Diarmuid1812/SensorNetworkDB/Arduino/KiCad_PCB_Humidity_Sensor_v5/Humidity_Sensor-Schematic.pdf

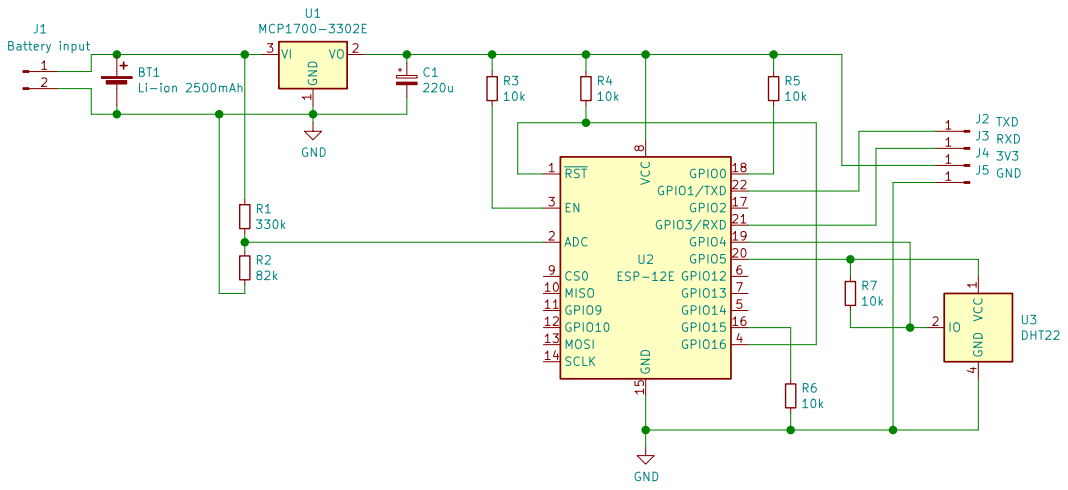
[picture p1: page 1]
