Diarmuid1812/SensorNetworkDB/Arduino/KiCad_PCB_Humidity_Sensor_v5/Humidity_Sensor-F-PCB.pdf

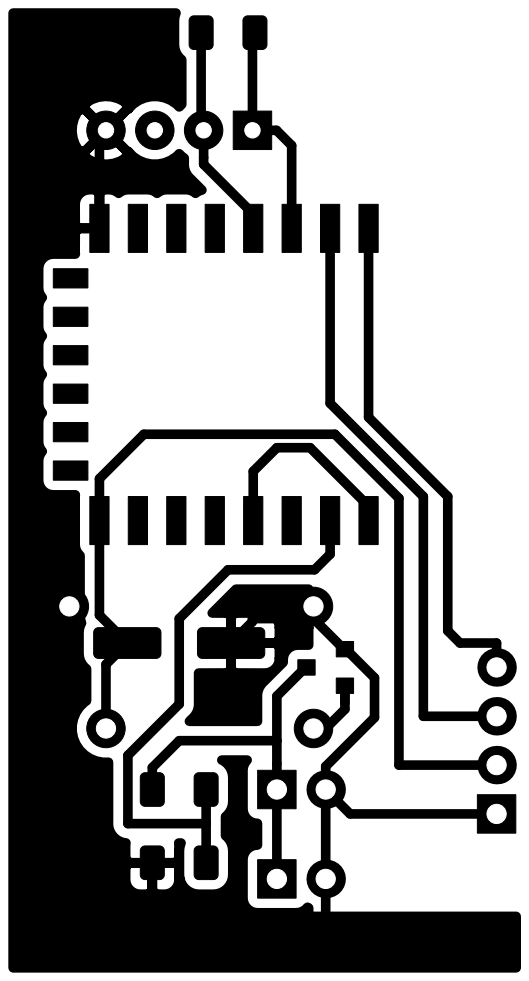
[picture p2: page 1]
