Diarmuid1812/SensorNetworkDB/Arduino/KiCad_PCB_Humidity_Sensor_v5/Humidity_Sensor.kicad_pcb

## KiCad design Arduino/KiCad_PCB_Humidity_Sensor_v5/Humidity_Sensor.kicad_pcb (2020-07-20)

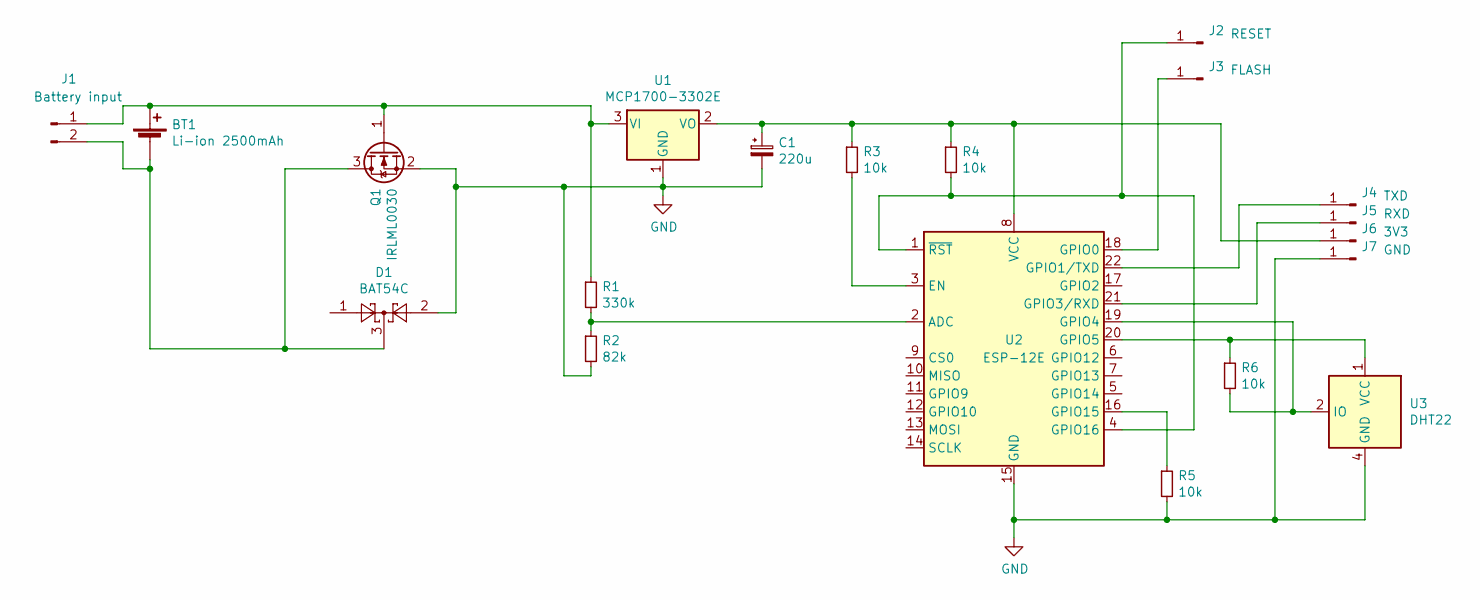
[picture p3: schematic Humidity_Sensor.sch]

Parts:
BT1: Li-ion 2500mAh; PinHeader_1x02_P2.54mm_Vertical
C1: 220u; CP_Elec_6.3x7.7
D1: BAT54C; SOT-23
J1: Battery input; PinHeader_1x02_P2.54mm_Vertical
J2: RESET; PinHeader_1x01_P2.54mm_Vertical
J3: FLASH; PinHeader_1x01_P2.54mm_Vertical
J4: TXD; PinHeader_1x01_P2.54mm_Vertical
J5: RXD; PinHeader_1x01_P2.54mm_Vertical
J6: 3V3; PinHeader_1x01_P2.54mm_Vertical
J7: GND; PinHeader_1x01_P2.54mm_Vertical
Q1: IRLML0030; SOT-23
R1: 330k; R_1206_3216Metric
R2: 82k; R_1206_3216Metric
R3, R4, R5, R6: 10k; R_1206_3216Metric
U1: MCP1700-3302E; SOT-23
U2: ESP-12E
U3: DHT22; Aosong_DHT11_5.5x12.0_P2.54mm

Connections:
GND: C1.2, D1.2, J7.1, Q1.2 (S), R2.2, R5.2, U1.1 (GND), U2.15 (GND), U3.4 (GND)
unnamed: BT1.1 (+), J1.1, Q1.1 (G), R1.1, U1.3 (VI)
unnamed: BT1.2 (-), D1.3, J1.2, Q1.3 (D)
unnamed: C1.1, J6.1, R3.1, R4.1, U1.2 (VO), U2.8 (VCC)
unnamed: J2.1, R4.2, U2.1 (~RST), U2.4 (GPIO16)
unnamed: J3.1, U2.18 (GPIO0)
unnamed: J4.1, U2.22 (GPIO1/TXD)
unnamed: J5.1, U2.21 (GPIO3/RXD)
unnamed: R1.2, R2.1, U2.2 (ADC)
unnamed: R3.2, U2.3 (EN)
unnamed: R5.1, U2.16 (GPIO15)
unnamed: R6.1, U2.20 (GPIO5), U3.1 (VCC)
unnamed: R6.2, U2.19 (GPIO4), U3.2 (IO)

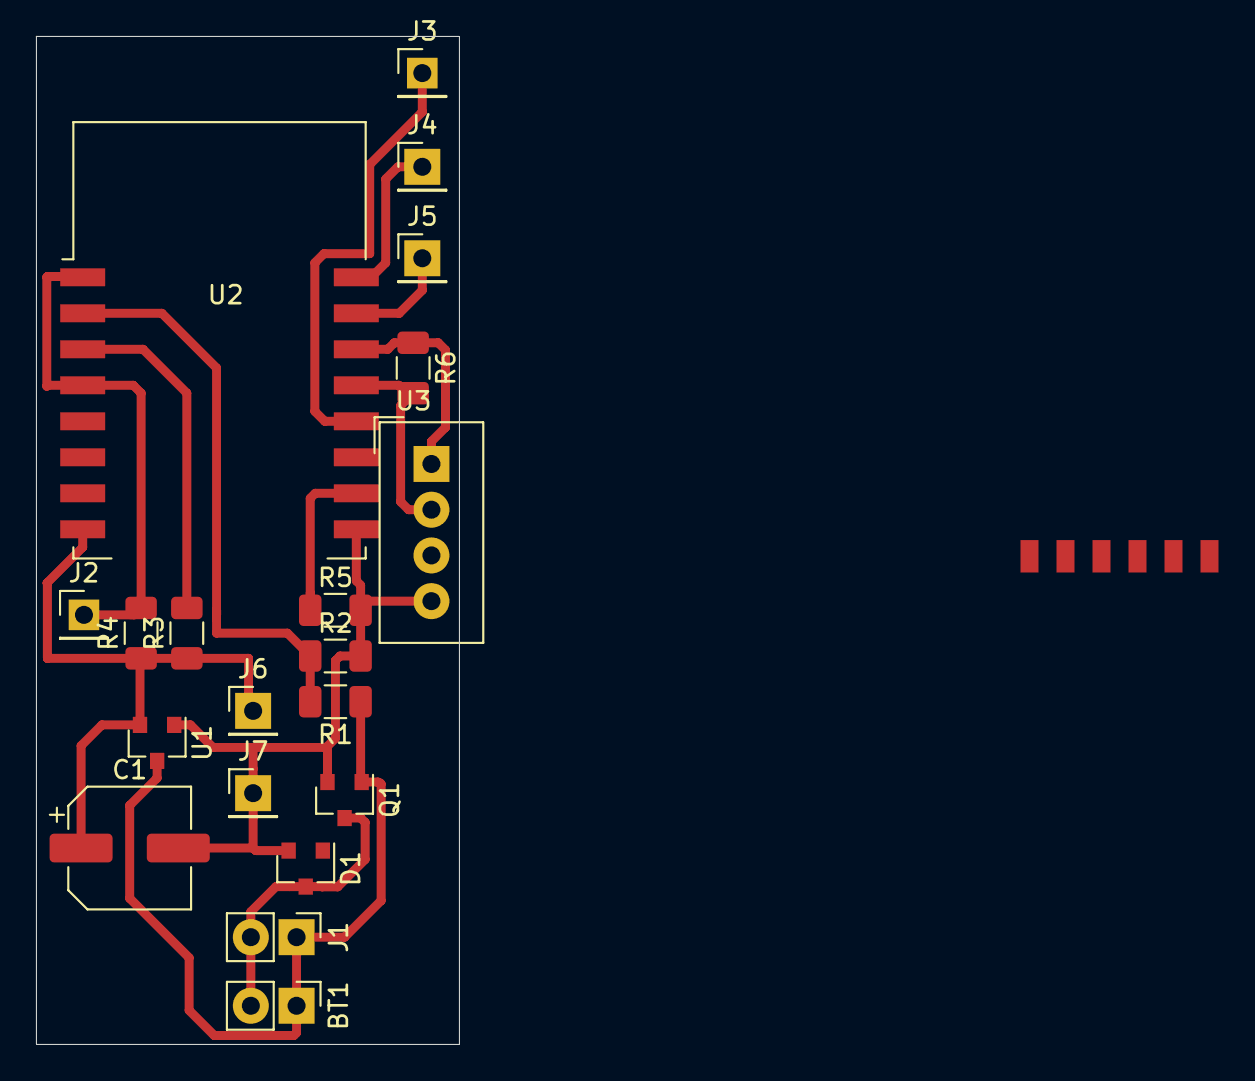
[picture p4: board Humidity_Sensor.kicad_pcb from above]

Board: 2 copper layers, 23.5 x 56.0 mm, 20 parts (0 on the bottom side), 13 nets.
