Diarmuid1812/SensorNetworkDB/Arduino/SensorNetwork/SensorNetwork.ino

#include "src/DHT_sensor_library/DHT.h"
#include <ESP8266WiFi.h>
#include <ESP8266HTTPClient.h>
#include <WiFiClient.h>
#include <EEPROM.h>

#include "user_interface.h"

#define DHTTYPE DHT22
#define DHT_VCC D1
#define DHT_PIN D2

#define SSID_EEPROM_ADDR 10
#define PASSWD_EEPROM_ADDR 50
#define IP_EEPROM_ADDR 90
#define RTCMEMORYSTART 65

#define SLEEP_TIME 3600                              //SLEEP_TIME to czas sekund jednego cyklu spania - docelowo godzina 60*60 = 3600 sekund

#define SENSOR_ID 1                               // <-- tutaj zmienić ID czujnika

typedef struct {
  int count;
} rtcStore;

DHT dht(DHT_PIN, DHTTYPE);

rtcStore rtcMem;

void setup()
{
  //uruchomienie portu szeregowego
  Serial.begin(74880);
  readFromRTCMemory();

  //czujnik ma się uruchamiać co 6 godzin
  if ((rtcMem.count <= 5) && (rtcMem.count >= 0))
  {
    Serial.print("Sleep number:");
    Serial.println(rtcMem.count);
    Serial.println("##########################################");
    rtcMem.count++;
    writeToRTCMemory();
    ESP.deepSleep(SLEEP_TIME * 1e6);
  }
  Serial.print("Sleep number:");
  Serial.println(rtcMem.count);
  rtcMem.count = 0;
  writeToRTCMemory();



  //ustawienie GPIO jako output
  pinMode(DHT_VCC, OUTPUT);
  //zasilenie czujnika DHT z GPIO
  digitalWrite(DHT_VCC, HIGH);
  //inicjalizacja czujnika wilgotności
  dht.begin();
  //uruchomienie EEPROM
  EEPROM.begin(512);

  String ssid = "ssid";
  String password = "password";
  String server_ip = "255.255.255.255";

  Serial.println("Waiting for wifi config");
  delay(3000);

  if (Serial.available() > 0)
  {
    String configMsg;
    configMsg = Serial.readString();

    //identyfikacja komendy nazwy sieci
    if (configMsg.substring(0, 5) == "ssid=")
    {
      ssid = configMsg.substring(5, configMsg.length() - 1);
      Serial.println("New ssid reeived");
      //Serial.println(ssid);

      //zapis ssid do EEPROM
      for (int i = 0; i < ssid.length(); i++)
      {
        char c = ssid[i];
        EEPROM.write(SSID_EEPROM_ADDR + i, c);
      }
      EEPROM.write(SSID_EEPROM_ADDR - 1, ssid.length());
      EEPROM.commit();
    }

    //identyfikacja komendy hasła
    if (configMsg.substring(0, 7) == "passwd=")
    {
      password = configMsg.substring(7, configMsg.length() - 1);
      Serial.println("New password received");
      //Serial.println(password);

      //zapis hasła do EEPROM
      for (int i = 0; i < password.length(); i++)
      {
        char c = password[i];
        EEPROM.write(PASSWD_EEPROM_ADDR + i, c);
      }
      EEPROM.write(PASSWD_EEPROM_ADDR - 1, password.length());
      EEPROM.commit();
    }

    //identyfikacja komendy ip serwera
    if (configMsg.substring(0, 3) == "ip=")
    {
      server_ip = configMsg.substring(3, configMsg.length() - 1);
      Serial.println("new server ip: ");
      Serial.println(server_ip);

      //zapis ip do EEPROM
      for (int i = 0; i < server_ip.length(); i++)
      {
        char c = server_ip[i];
        EEPROM.write(IP_EEPROM_ADDR + i, c);
      }
      EEPROM.write(IP_EEPROM_ADDR - 1, server_ip.length());
      EEPROM.commit();
    }

    //identyfikacja komendy resetu do ustawień fabrycznych
    if (configMsg.substring(0, 1) == "x")
    {
      ssid = "ssid";
      password = "passwd";
      server_ip = "server_ip";

      //zapis ssid do EEPROM
      for (int i = 0; i < ssid.length(); i++)
      {
        char c = ssid[i];
        EEPROM.write(SSID_EEPROM_ADDR + i, c);
      }
      EEPROM.write(SSID_EEPROM_ADDR - 1, ssid.length());
      EEPROM.commit();

      //zapis hasła do EEPROM
      for (int i = 0; i < password.length(); i++)
      {
        char c = password[i];
        EEPROM.write(PASSWD_EEPROM_ADDR + i, c);
      }
      EEPROM.write(PASSWD_EEPROM_ADDR - 1, password.length());
      EEPROM.commit();

      //zapis ip do EEPROM
      for (int i = 0; i < server_ip.length(); i++)
      {
        char c = server_ip[i];
        EEPROM.write(IP_EEPROM_ADDR + i, c);
      }
      EEPROM.write(IP_EEPROM_ADDR - 1, server_ip.length());
      EEPROM.commit();
      Serial.println("Default settings restored");
    }


  }

  //odczyt ssid i hasła z EEPROM
  ssid = "";
  for (int i = 0; i < EEPROM.read(SSID_EEPROM_ADDR - 1); i++)
  {
    ssid += char(EEPROM.read(SSID_EEPROM_ADDR + i));
  }
  password = "";
  for (int i = 0; i < EEPROM.read(PASSWD_EEPROM_ADDR - 1); i++)
  {
    password += char(EEPROM.read(PASSWD_EEPROM_ADDR + i));
  }
  //odczyt ip serwera z EEPROM
  server_ip = "";
  for (int i = 0; i < EEPROM.read(IP_EEPROM_ADDR - 1); i++)
  {
    server_ip += char(EEPROM.read(IP_EEPROM_ADDR + i));
  }


//  Serial.print("ssid: ");
//  Serial.println(ssid);
//  Serial.print("password: ");
//  Serial.println(password);
//  Serial.print("server ip: ");
//  Serial.println(server_ip);



  //odczyt wilgotności, temperatury i napięcia baterii
  float humidity = dht.readHumidity();
  float temperature = dht.readTemperature();
  float raw_battery = float(analogRead(A0)) / 1024 * 5.02;

  
  int battery = mapf(raw_battery, 3.3, 4.2, 0, 100);
  if (battery > 100)
  {
    battery = 100;
  }
  if (battery < 0)
  {
    battery = 0;
  }

  Serial.print("temp: ");
  Serial.println(temperature);
  Serial.print("hum: ");
  Serial.println(humidity);
  Serial.print("analog: ");
  Serial.println(raw_battery);
  Serial.print("battery percent: ");
  Serial.println(battery);
  Serial.println();

  //ustaw esp w trybie klienta wifi
  WiFi.mode(WIFI_STA);
  WiFi.disconnect();




  WiFi.begin(ssid, password);
  Serial.println("Connecting to wifi");

  int timeout = 0;
  while (WiFi.status() != WL_CONNECTED)
  {
    delay(500);
    Serial.print(".");
    timeout++;
    if (timeout >= 80)
    {
      Serial.println("No wifi connection found");
      Serial.println("Sleep");
      Serial.println("##########################################");
      ESP.deepSleep(SLEEP_TIME * 1e6);
    }
  }
  Serial.println("");
  Serial.print("Connected to WiFi network with IP Address: ");
  Serial.println(WiFi.localIP());

  HTTPClient http;
  Serial.print("http.begin() = ");
  String beginCommand = "http://" + server_ip + "/sn/com/comPost.php";
  Serial.println(beginCommand);
  Serial.println(http.begin(beginCommand));
  http.addHeader("Content-Type", "application/x-www-form-urlencoded");

  String id = "&id=" + String(SENSOR_ID);
  String temp = "&temperature=";
  String hum = "&humidity=";
  String bat = "&battery=";

  String httpRequestData = id + temp + String(temperature) + hum + String(humidity) + bat + String(battery) + "";
  Serial.print("httpRequestData: ");
  Serial.println(httpRequestData);

  int httpResponseCode = http.POST(httpRequestData);

  if (httpResponseCode > 0)
  {
    Serial.print("HTTP Response code: ");
    Serial.println(httpResponseCode);
  }
  else
  {
    Serial.print("Error code: ");
    Serial.println(httpResponseCode);
  }
  http.end();

  Serial.println("Sleep");
  Serial.println("##########################################");
  ESP.deepSleep(SLEEP_TIME * 1e6);
}

void loop()
{

}

void readFromRTCMemory()
{
  system_rtc_mem_read(RTCMEMORYSTART, &rtcMem, sizeof(rtcMem));
  yield();
}

void writeToRTCMemory()
{
  system_rtc_mem_write(RTCMEMORYSTART, &rtcMem, 4);
  yield();
}

float mapf(float x, float in_min, float in_max, float out_min, float out_max) {
  return (x - in_min) * (out_max - out_min) / (in_max - in_min) + out_min;
}
