Diarmuid1812/SensorNetworkDB/(commit log)

2020-05-27 Poprawiony raport
    [sample.csv]
2020-06-02 Restrukturyzacja, backupy bazy
    [last_report.csv]
2020-06-02 Dodanie resetu czujnika do ustawień fabrycznych
    +dodanie opcji "x" resetującej ustawienia czujnika
    +poprawienie błędu w czekaniu na kolejne cykle uśpienia
    +zmiana wsółczynnika skalowania napięcia baterii
    [SensorNetwork.ino]
2020-07-20 Schemat i PCB czujnika
    Schemat i PCB czujnika w KiCad i wyeksportowane w PDF
    [Humidity_Sensor.kicad_pcb, Humidity_Sensor.sch]
